cryptovillage/badge2016/hardware/blinkybadge.pdf

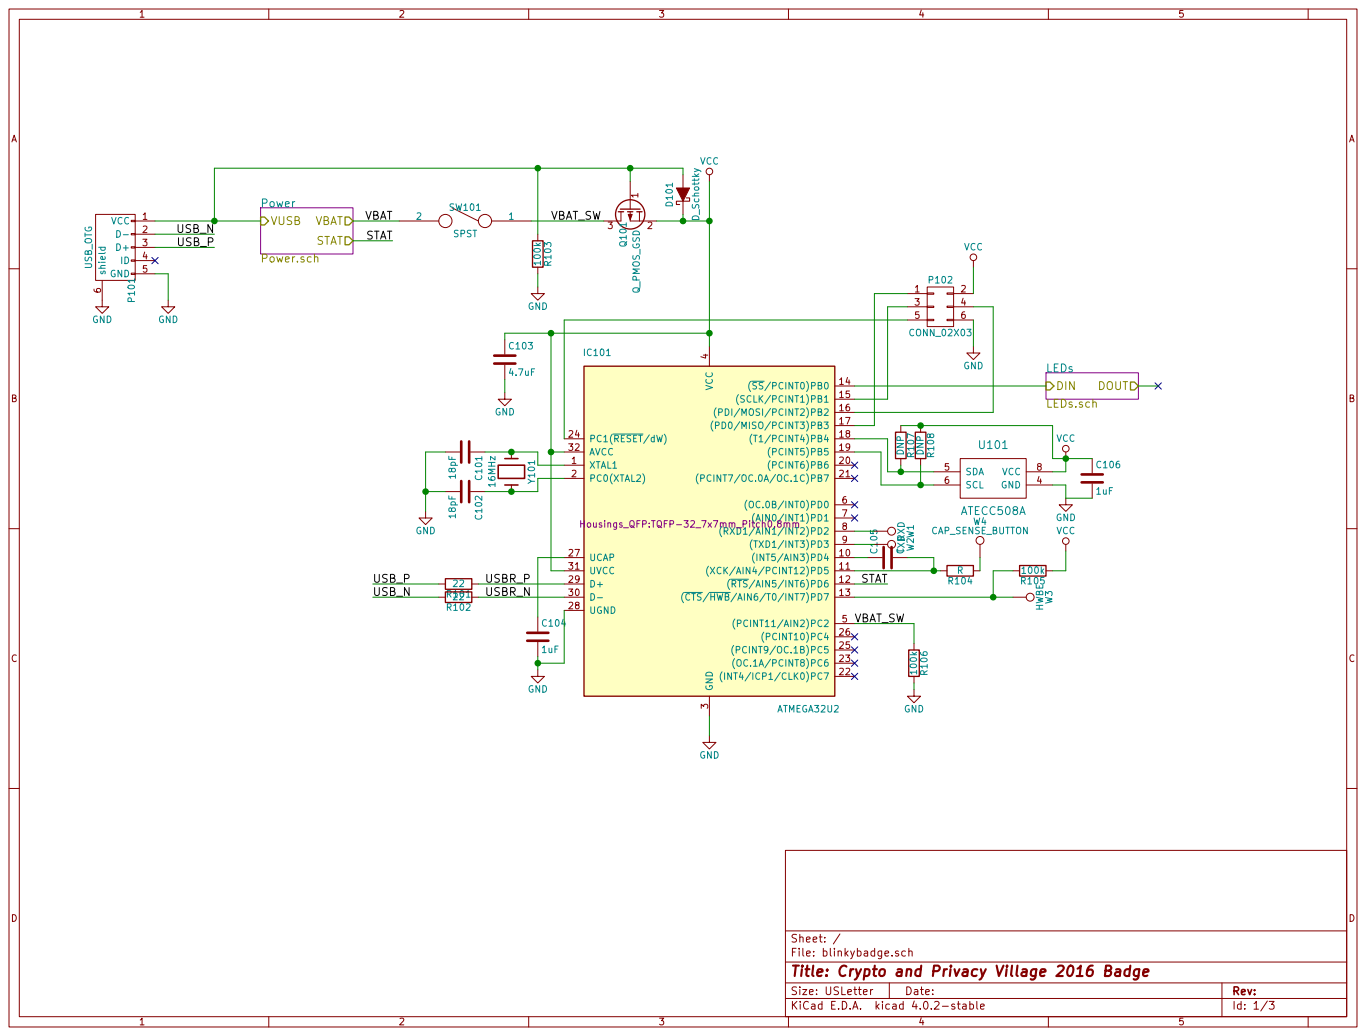
[picture p1: page 1]

6 P101 USB_OTG GND GND Power Power.sch VUSB

File: blinkybadge.sch Sheet: /
Id: 1/3 Title: Crypto and Privacy Village 2016 Badge

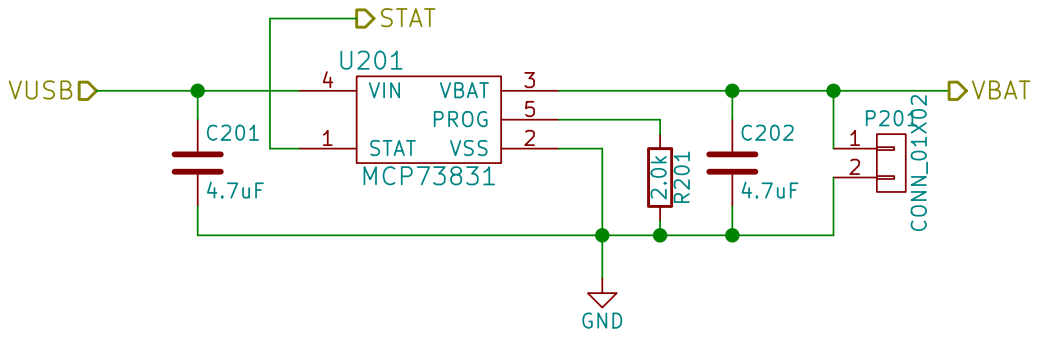
[picture p2: page 2]

Id: 2/3 Title: CPV 2016 Badge LiPo Power File: Power.sch Sheet: /Power/

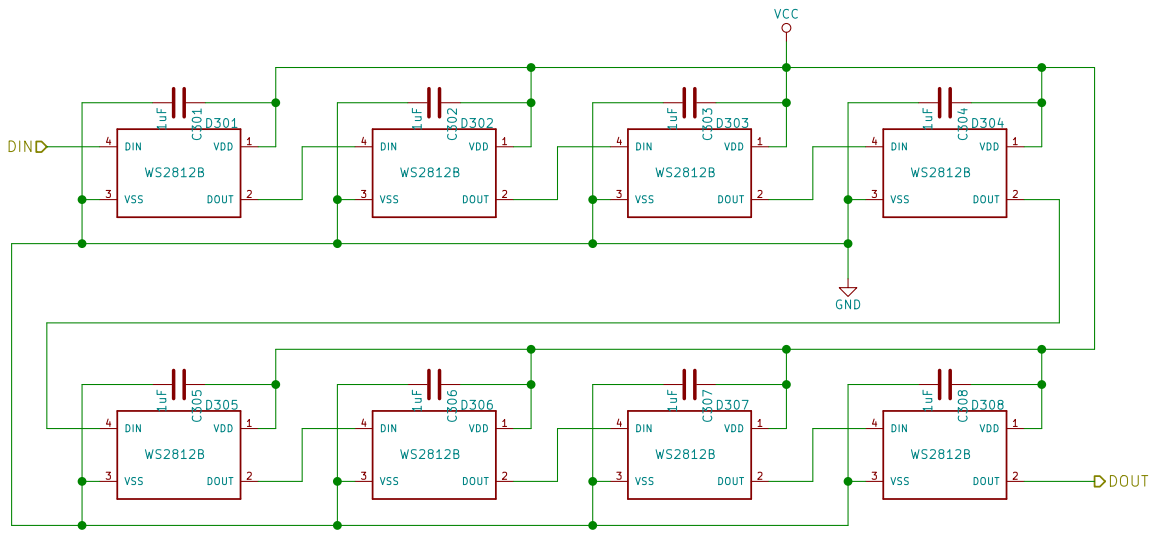
[picture p3: page 3]

File: LEDs.sch Sheet: /LEDs/
Id: 3/3 Title: CPV Badge 2016 LEDs
