cryptovillage/badge2016/firmware/blinkybadge/src/QTouch/qt_asm_avr.h

/* This source file is part of the ATMEL QTouch Library Release 4.3.1 */
/* This file is prepared for Doxygen automatic documentation generation. */
/*! \file *********************************************************************
 *
 * \brief  This file contains the QTouch Libary configuration options for
 *         AVR 8-bit QTouch method Capacitive Touch acquisition.
 *
 * - Compiler:           IAR EWAVR and GNU GCC for AVR.
 * - Supported devices:  Atmel AVR 8-bit.
 * - Userguide:          QTouch Library User Guide - doc8207.pdf.
 * - Support email:      www.atmel.com/design-support/
 *
 * \author               Atmel Corporation: http://www.atmel.com \n
 *                       Support and FAQ: http://support.atmel.no/
 *
 ******************************************************************************/

/* Copyright (c) 2010 Atmel Corporation. All rights reserved.
 *
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
 * 3. The name of Atmel may not be used to endorse or promote products derived
 * from this software without specific prior written permission.
 *
 * 4. This software may only be redistributed and used in connection with an Atmel
 * AVR product.
 *
 * THIS SOFTWARE IS PROVIDED BY ATMEL "AS IS" AND ANY EXPRESS OR IMPLIED
 * WARRANTIES, INCLUDING, BUT NOT LIMITED TO, THE IMPLIED WARRANTIES OF
 * MERCHANTABILITY, FITNESS FOR A PARTICULAR PURPOSE AND NON-INFRINGEMENT ARE
 * EXPRESSLY AND SPECIFICALLY DISCLAIMED. IN NO EVENT SHALL ATMEL BE LIABLE FOR
 * ANY DIRECT, INDIRECT, INCIDENTAL, SPECIAL, EXEMPLARY, OR CONSEQUENTIAL DAMAGES
 * (INCLUDING, BUT NOT LIMITED TO, PROCUREMENT OF SUBSTITUTE GOODS OR SERVICES;
 * LOSS OF USE, DATA, OR PROFITS; OR BUSINESS INTERRUPTION) HOWEVER CAUSED AND
 * ON ANY THEORY OF LIABILITY, WHETHER IN CONTRACT, STRICT LIABILITY, OR TORT
 * (INCLUDING NEGLIGENCE OR OTHERWISE) ARISING IN ANY WAY OUT OF THE USE OF THIS
 * SOFTWARE, EVEN IF ADVISED OF THE POSSIBILITY OF SUCH DAMAGE
 *
 */

#ifndef _QT_ASM_AVR_H_
#define _QT_ASM_AVR_H_

#include "touch.h"

/**
  * Warning: Please do not change any part of the code below this line.
  */
#if (QT_DELAY_CYCLES == 0)
#error 'QT_DELAY_CYCLES can only have values in the range 1-255.'
#endif

#if !(defined(__AVR32__) || defined(__ICCAVR32__))
#if ((QT_NUM_CHANNELS == 8) || (QT_NUM_CHANNELS == 4))

#ifdef QTOUCH_STUDIO_MASKS
#define QTOUCH_PIN_CONF 1
#define _STATIC_PORT_PIN_CONF_ 1
#else
#define QTOUCH_PIN_CONF 0
#define _STATIC_PORT_PIN_CONF_ 0
#endif

#ifdef _SNS1_SNSK1_SAME_PORT_
#define _STATIC_PORT_PIN_CONF_ 1
#define INTRABURST_1 1

#if (QT_NUM_CHANNELS == 4)
#define QTOUCH_SNS_PORT_COUNT 1
#define INTRABURST_2 0
#elif (QT_NUM_CHANNELS == 8)
#define QTOUCH_SNS_PORT_COUNT 2
#define INTRABURST_2 1
#endif
#else

#define QTOUCH_SNS_PORT_COUNT 1
#define INTRABURST_1 0
#define INTRABURST_2 0
#endif
#elif ((QT_NUM_CHANNELS == 16) || (QT_NUM_CHANNELS == 12))
#define _STATIC_PORT_PIN_CONF_ 1
#define QTOUCH_SNS_PORT_COUNT 2

#ifdef QTOUCH_STUDIO_MASKS
#define QTOUCH_PIN_CONF 1
#else
#define QTOUCH_PIN_CONF 0
#endif

#ifdef _SNS1_SNSK1_SAME_PORT_
#define INTRABURST_1 1
#else
#define INTRABURST_1 0
#endif

#ifdef _SNS2_SNSK2_SAME_PORT_
#define INTRABURST_2 1
#else
#define INTRABURST_2 0
#endif

#if ((INTRABURST_1== 1) && (INTRABURST_2== 1))
#error 'QT_NUM_CHANNELS value should be 8 in this case.'
#elif ((INTRABURST_1== 1) || (INTRABURST_2== 1))
#if (QT_NUM_CHANNELS == 16)
#error 'QT_NUM_CHANNELS value should be 12 in this case.'
#endif
#elif ((INTRABURST_1== 0) && (INTRABURST_2== 0))
#if (QT_NUM_CHANNELS == 12)
#error 'QT_NUM_CHANNELS value should be 16 in this case.'
#endif
#endif
#elif (QT_NUM_CHANNELS == 32)
#define _STATIC_PORT_PIN_CONF_ 1
#define QTOUCH_SNS_PORT_COUNT 2
#define QTOUCH_PIN_CONF 0
#ifdef _SNS1_SNSK1_SAME_PORT_
#define INTRABURST_1 1
#else
#define INTRABURST_1 0
#endif

#ifdef _SNS2_SNSK2_SAME_PORT_
#define INTRABURST_2 1
#else
#define INTRABURST_2 0
#endif
#else
#error 'QT_NUM_CHANNELS specified is not supported.'
#endif
#else
#ifdef _SNS1_SNSK1_SAME_PORT_
#define _STATIC_PORT_PIN_CONF_ 1
#define QTOUCH_SNS_PORT_COUNT 1
#define INTRABURST_1 1
#define INTRABURST_2 0
#else
#define _STATIC_PORT_PIN_CONF_ 0
#define QTOUCH_SNS_PORT_COUNT 1
#define INTRABURST_1 0
#define INTRABURST_2 0
#endif
#endif

#if (defined(__IAR_SYSTEMS_ASM__) || defined(__ASSEMBLER__) || defined(__ICCAVR32__) || defined(__AVR32__))
#if (defined(__IAR_SYSTEMS_ASM__) || defined(__ICCAVR32__))
#if defined(__IAR_SYSTEMS_ASM__)
#include <ioavr.h>
#define p_1 r16
#define p_2 r17
#define p_3 r18
#define p_4 r19
#define p_5 r20
#define r_v r16
#define FILE_HEADER NAME qt_asm_iar
#define FILE_FOOTER END
#define FILE_SEGMENT RSEG CODE
#define GLOBAL_FUNCTION PUBLIC

#define GLOBAL_VAR EQU
#elif defined(__ICCAVR32__)
#include <avr32/io.h>
#define p_1 r12
#define p_2 r11
#define p_3 r10
#define r_v r12
#define _UC3A_

#define _QTOUCH_
	    //#define FILE_HEADER NAME qt_asm_iar
	    //#define FILE_FOOTER END
	    //#define FILE_SEGMENT RSEG CODE
#define FILE_HEADER
#define FILE_FOOTER
#define FILE_SEGMENT
#define GLOBAL_FUNCTION PUBLIC
#endif
#elif (defined(__ASSEMBLER__) || defined(__AVR32__))
#if defined(__AVR32__)
#include <avr32/io.h>

#define p_1 r12
#define p_2 r11
#define p_3 r10
#define r_v r12


#define _QTOUCH_
#define _UC3A_
#define _STATIC_PORT_PIN_CONF_ 0
#define QTOUCH_SNS_PORT_COUNT 1
#define INTRABURST_1 0
#define INTRABURST_2 0
#else
#define __SFR_OFFSET 0
#include <avr/io.h>
#define p_1 r24
#define p_2 r22
#define p_3 r20
#define p_4 r18
#define p_5 r16
#define r_v r24

#define GLOBAL_VAR .EQU
#endif

#define FILE_HEADER
#define FILE_FOOTER
#define FILE_SEGMENT
#define GLOBAL_FUNCTION .global
#else
#error 'Assembler not supported.'
#endif

#define JOIN( x, y ) x ## y
#define JOIN1( A, B, C ) A ## B ## C
#define REG( REGISTER, SIDE ) JOIN( REGISTER, SIDE )
#define CONCAT( A, B, C ) JOIN1( A, B, C )

#define sreg_save r2

#define _00011001_	nop
#define _01101001_	brne _111_
#define _01101011_	brne _222_
#define _10001110_	rjmp .
#if (defined (__AVR32__) || defined (__ICCAVR32__))
#define _10100011_	_111_: sub r9,1
#define _10100111_	_222_: sub r9,1
#define _11100011_	mov r9,((QT_DELAY_CYCLES - 1)/3)
#else
#define _10100011_	_111_: dec r19
#define _10100111_	_222_: dec r19
#define _11100011_	ldi r19,((QT_DELAY_CYCLES - 1)/3)
#endif

#else

#ifndef _QTOUCH_
#define _QTOUCH_
#endif
#endif

#endif /*_QT_ASM_AVR8_H_*/
