cryptovillage/badge2016/firmware/blinkybadge/atecc508a.c

/*
 * Copyright (c) 2016, Conor Patrick
 * Copyright (c) 2016, Karl Koscher
 * All rights reserved.
 *
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
 * THIS SOFTWARE IS PROVIDED BY THE COPYRIGHT HOLDERS AND CONTRIBUTORS "AS IS" AND
 * ANY EXPRESS OR IMPLIED WARRANTIES, INCLUDING, BUT NOT LIMITED TO, THE IMPLIED
 * WARRANTIES OF MERCHANTABILITY AND FITNESS FOR A PARTICULAR PURPOSE ARE
 * DISCLAIMED. IN NO EVENT SHALL THE COPYRIGHT OWNER OR CONTRIBUTORS BE LIABLE FOR
 * ANY DIRECT, INDIRECT, INCIDENTAL, SPECIAL, EXEMPLARY, OR CONSEQUENTIAL DAMAGES
 * (INCLUDING, BUT NOT LIMITED TO, PROCUREMENT OF SUBSTITUTE GOODS OR SERVICES;
 * LOSS OF USE, DATA, OR PROFITS; OR BUSINESS INTERRUPTION) HOWEVER CAUSED AND
 * ON ANY THEORY OF LIABILITY, WHETHER IN CONTRACT, STRICT LIABILITY, OR TORT
 * (INCLUDING NEGLIGENCE OR OTHERWISE) ARISING IN ANY WAY OUT OF THE USE OF THIS
 * SOFTWARE, EVEN IF ADVISED OF THE POSSIBILITY OF SUCH DAMAGE.

 * The views and conclusions contained in the software and documentation are those
 * of the authors and should not be interpreted as representing official policies,
 * either expressed or implied, of the FreeBSD Project.
 *
 * atecc508.c
 * 		Implementation for ATECC508 peripheral.
 *
 */
#include <stdint.h>
#include <stdlib.h>
#include <util/delay.h>
#include "blinkybadge.h"
#include "atecc508a.h"
#include "twi.h"

int8_t atecc_send(uint8_t cmd, uint8_t p1, uint16_t p2,
					uint8_t * buf, uint8_t len)
{
	static uint8_t params[6];
	params[0] = 0x3;
	params[1] = 7+len;
	params[2] = cmd;
	params[3] = p1;
	params[4] = p2 & 0xff;
	params[5] = p2 >> 8;

	if (twiSendExtPkt(ATECC508A_ADDR, params, sizeof(params), buf, len)) {
		return -1;
	}
	
	return 0;
}

void atecc_idle()
{
	twiSendPkt(ATECC508A_ADDR, "\x02", 1);
}

void atecc_sleep()
{
	twiSendPkt(ATECC508A_ADDR, "\x01", 1);
}

void atecc_wake()
{
	twiRecvPkt(0x7F, NULL, 0); // Resync I2C
	twiSendPkt(ATECC508A_ADDR, "\0\0", 2);
}

int8_t atecc_recv(uint8_t * buf, uint8_t buflen, struct atecc_response* res)
{
	uint8_t pkt_len;
	pkt_len = twiRecvVariableLenPkt(ATECC508A_ADDR, buf, buflen);
	if (pkt_len == 0)
	{
		return -1;
	}

	if (pkt_len <= buflen && pkt_len >= 4)
	{
		
		/* FIXME
		if (PKT_CRC(buf,pkt_len) != SMB_crc)
		{
			set_app_error(ERROR_I2C_CRC);
			return -1;
		}
		*/
	}
	else
	{
		set_app_error(ERROR_I2C_BAD_LEN);
		return -1;
	}

	if (pkt_len == 4 && buf[1] != 0)
	{
		set_app_error(buf[1]);
		return -1;
	}

	if (res != NULL)
	{
		res->len = pkt_len - 3;
		res->buf = buf+1;
	}
	return pkt_len;
}

static void delay_cmd(uint8_t cmd)
{
	uint8_t d = 0;
	switch(cmd)
	{
		case ATECC_CMD_SIGN:
			d = 50;
			break;
		case ATECC_CMD_GENKEY:
			d = 100;
			break;
		default:
			d = 32;
			break;
	}
	u2f_delay(d);
}

int8_t atecc_send_recv(uint8_t cmd, uint8_t p1, uint16_t p2,
							uint8_t* tx, uint8_t txlen, uint8_t * rx,
							uint8_t rxlen, struct atecc_response* res)
{
	uint8_t errors = 0;
	resend:
	atecc_wake();
	set_app_error(0);
	while(atecc_send(cmd, p1, p2, tx, txlen))
	{
		u2f_delay(10);
		errors++;
		if (errors > 8)
		{
			return -1;
		}
	}
	while(atecc_recv(rx,rxlen, res) == -1)
	{
		errors++;
		if (errors > 5)
		{
			return -2;
		}
		switch(get_app_error())
		{
			case ERROR_NOTHING:
				delay_cmd(cmd);
				break;
			default:
				u2f_delay(cmd);
				goto resend;
				break;
		}

	}
	atecc_idle();
	return 0;
}

int8_t atecc_write_eeprom(uint8_t base, uint8_t offset, uint8_t* srcbuf, uint8_t len)
{
	uint8_t buf[7];
	struct atecc_response res;

	uint8_t * dstbuf = srcbuf;
	if (offset + len > 4)
		return -1;
	if (len < 4)
	{
		atecc_send_recv(ATECC_CMD_READ,
				ATECC_RW_CONFIG, base, NULL, 0,
				buf, sizeof(buf), &res);

		dstbuf = res.buf;
		memmove(res.buf + offset, srcbuf, len);
	}

	atecc_send_recv(ATECC_CMD_WRITE,
			ATECC_RW_CONFIG, base, dstbuf, 4,
			buf, sizeof(buf), &res);

	if (get_app_error()) {
		return -1;
	}
	return 0;
}

int is_locked(uint8_t * buf)
{
	struct atecc_response res;
	atecc_send_recv(ATECC_CMD_READ,
					ATECC_RW_CONFIG,87/4, NULL, 0,
					buf, 36, &res);
	//dump_hex(res.buf, res.len);
	if (res.buf[87 % 4] == 0)
		return 1;
	else
		return 0;
}

static void dump_config(uint8_t* buf)
{
	uint8_t i,j;
	//uint16_t crc = 0;
	struct atecc_response res;
	for (i=0; i < 4; i++)
	{
		atecc_send_recv(ATECC_CMD_READ,
				ATECC_RW_CONFIG | ATECC_RW_EXT, i << 3, NULL, 0,
				buf, 40, &res);
		/*for(j = 0; j < res.len; j++)
		{
			crc = feed_crc(crc,res.buf[j]);
		}
		*/
		//dump_hex(res.buf,res.len);
	}

	//u2f_printx("config crc:", 1,reverse_bits(crc));
}

int8_t atecc_setup_config()
{
	struct atecc_response res;
	uint8_t i;

	struct atecc_slot_config sc;
	struct atecc_key_config kc;
	memset(&sc, 0, sizeof(struct atecc_slot_config));
	memset(&kc, 0, sizeof(struct atecc_key_config));
	sc.readkey = 3;
	sc.secret = 1;
	sc.writeconfig = 0xa;

	// set up read/write permissions for keys
	for (i = 0; i < 16; i++)
	{
		if ( atecc_write_eeprom(ATECC_EEPROM_SLOT(i), ATECC_EEPROM_SLOT_OFFSET(i), &sc, ATECC_EEPROM_SLOT_SIZE) != 0)
		{
			//u2f_printb("1 atecc_write_eeprom failed ",1, i);
			return -1;
		}

	}

	kc.private = 1;
	kc.pubinfo = 1;
	kc.keytype = 0x4;
	kc.lockable = 0;

	// set up config for keys
	for (i = 0; i < 16; i++)
	{
		/*
		if (i==15)
		{
			kc.lockable = 1;
		}
		*/
		if ( atecc_write_eeprom(ATECC_EEPROM_KEY(i), ATECC_EEPROM_KEY_OFFSET(i), &kc, ATECC_EEPROM_KEY_SIZE) != 0)
		{
			//u2f_printb("3 atecc_write_eeprom failed " ,1,i);
			return -2;
		}

	}

	//dump_config(buf);
	return 0;
}
