cryptovillage/badge2016/(commit log)

2016-06-30 Initial commit of an empty KiCAD project
    [blinkybadge.kicad_pcb, blinkybadge.sch]
2016-07-06 Schematic is mostly done
    [Power.sch, blinkybadge.sch]
2016-07-07 Added edge.
    [blinkybadge.kicad_pcb]
2016-07-07 Add LEDs
    [LEDs.sch, Power.sch, blinkybadge.sch]
2016-07-07 Moar LEDs
    [LEDs.sch]
2016-07-07 Hex shape.
    [blinkybadge.kicad_pcb]
2016-07-07 better hex.
    [blinkybadge.kicad_pcb]
2016-07-07 Add annotations
    [LEDs.sch, Power.sch, blinkybadge.sch]
2016-07-07 back silkscreen
    [blinkybadge.kicad_pcb]
2016-07-07 Add passives for touch sensor
    [LEDs.sch, Power.sch, blinkybadge.sch]
2016-07-08 Update footprints
    [LEDs.sch, Power.sch, blinkybadge.sch]
2016-07-08 Add more footprints
2016-07-08 Update some footprint assignments
    [Power.sch, blinkybadge.sch]
2016-07-09 Begin layout work
    [LEDs.sch, blinkybadge.kicad_pcb, blinkybadge.sch]
2016-07-11 More layout
    [blinkybadge.kicad_pcb, blinkybadge.sch]
2016-07-11 More layoyut
    [blinkybadge.kicad_pcb]
2016-07-12 Layout complete
    [LEDs.sch, Power.sch, blinkybadge.kicad_pcb, blinkybadge.sch]
2016-07-12 Add some layout tweaks
    [blinkybadge.kicad_pcb, blinkybadge.sch]
2016-07-12 Add footprints and the EURion constellations
    [LEDs.sch, Power.sch, blinkybadge.kicad_pcb, blinkybadge.sch]
2016-07-20 Fix battery connector footprint
    [blinkybadge.kicad_pcb]
2016-07-21 Change JST footprint
2016-07-21 Fix PMOS pinout
    [LEDs.sch, Power.sch, blinkybadge.kicad_pcb, blinkybadge.sch]
2016-07-21 Remove EURions
    [blinkybadge.kicad_pcb]
2016-07-21 Final tweaks
    [blinkybadge.kicad_pcb, blinkybadge.sch]
2016-08-02 Move reprogrammable pages to fixed locations in flash
    [animation.c, blinkybadge.c, u2f_atecc.c, ws2812.c, ws2812.h]
2016-08-06 Add BOM
2016-08-06 Add production gerbers
    [blinkybadge-B.Cu.gbr, blinkybadge-B.Mask.gbr, blinkybadge-B.SilkS.gbr, blinkybadge-Edge.Cuts.gbr, blinkybadge-F.Cu.gbr, blinkybadge-F.Mask.gbr, blinkybadge-F.SilkS.gbr, blinkybadge.drl]
2016-08-06 Add schematic
2016-08-28 Update BOM to correct ATmega part
